atmelino/MPPT/README.md

# MPPT
Maximum Power Point Tracking Solar Powered Computer 

https://atmelino.github.io/MPPT/
