atmelino/MPPT/version4_0/README.md

# MPPT
Maximum Power Point Tracking Solar Powered Computer 

https://atmelino.github.io/MPPT/
