atmelino/MPPT/version1_0/README.md

# Arduino

Contents:

<h2>MPPT Arduino</h2>

Arduino code for Maximum Power Point Tracker project

<a href="https://hackaday.io/project/10671-arduino-mppt-solar-charge-controller">https://hackaday.io/project/10671-arduino-mppt-solar-charge-controller</a>
