atmelino/MPPT/version1_0/wiki_backup/images.md

images:

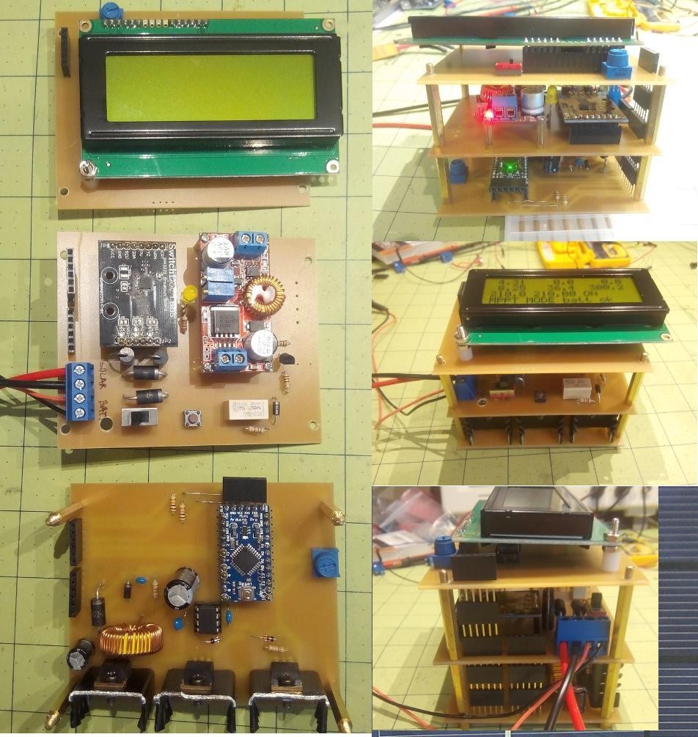
[picture p1: docs/wiki_backup/images/MPPT01.jpeg]
