atmelino/MPPT/docs/images/2oBEy.jpg

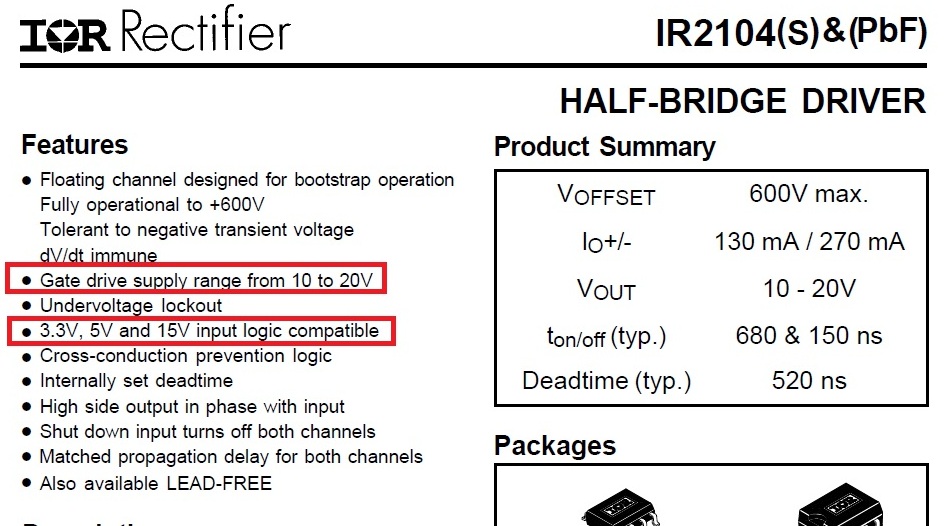
docs/images/2oBEy.jpg
