atmelino/MPPT/docs/images/currentlimit01.png

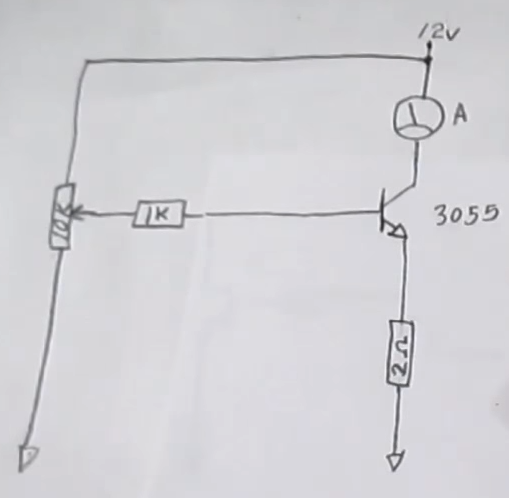
docs/images/currentlimit01.png
