atmelino/MPPT/docs/images/currentlimit02.png

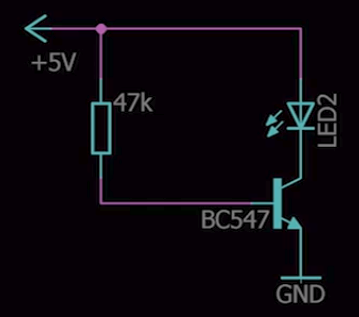
docs/images/currentlimit02.png
