atmelino/MPPT/docs/images/TykPZ.png

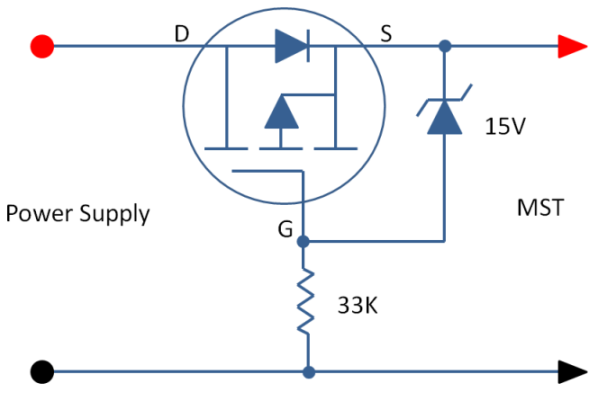
docs/images/TykPZ.png
