atmelino/MPPT/docs/images/version4_0/board.png

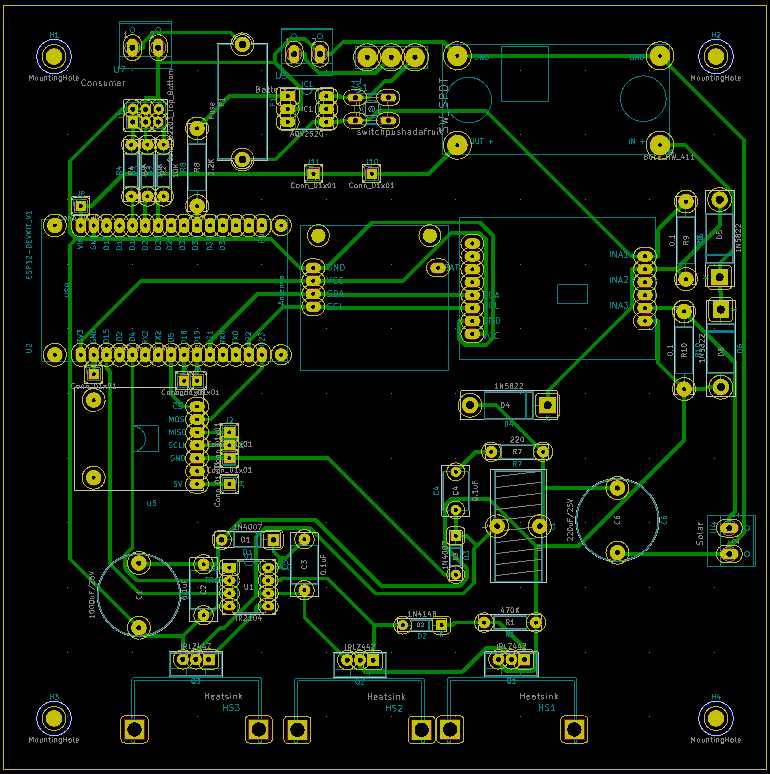
docs/images/version4_0/board.png
