atmelino/MPPT/docs/images/version4_0/schematic.png

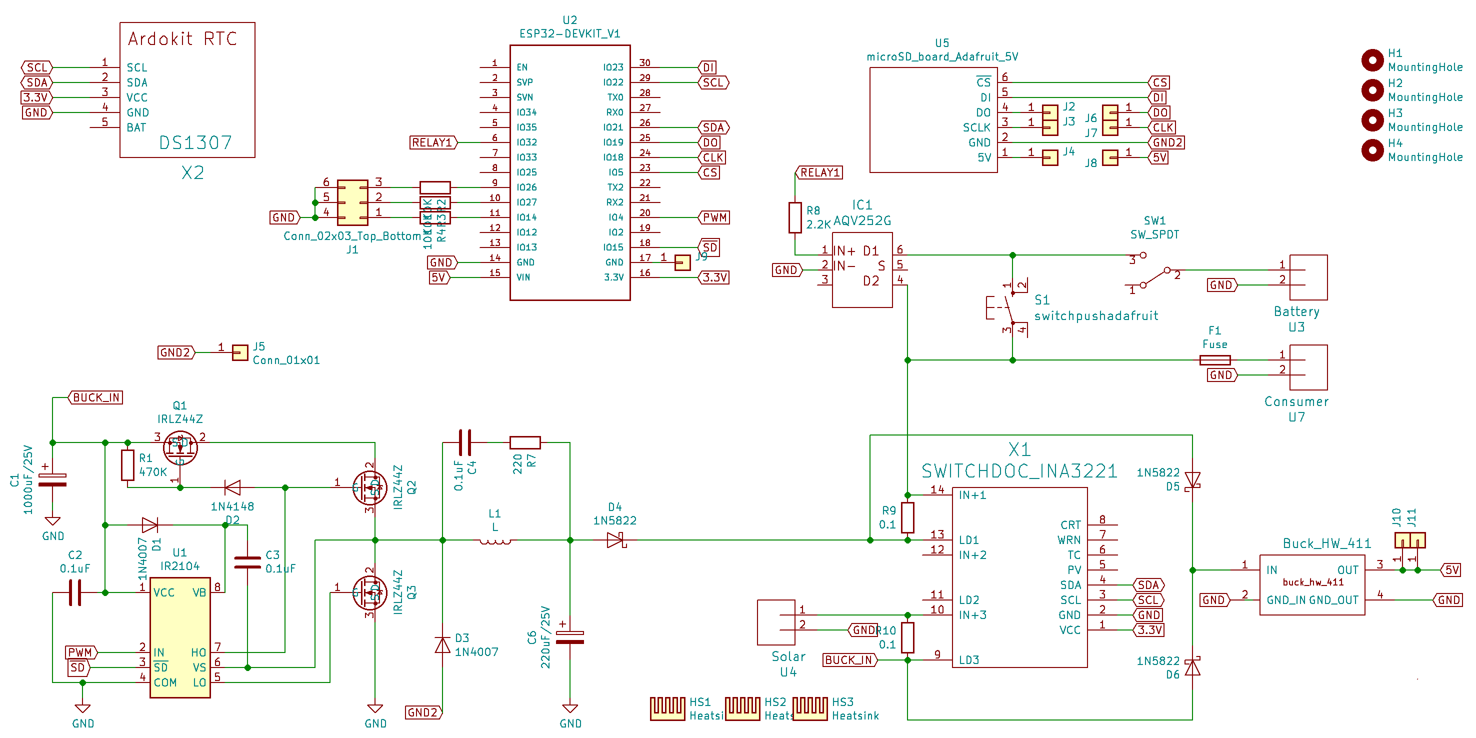
docs/images/version4_0/schematic.png
