atmelino/MPPT/version1_1/kicad/MPPT/MPPT_LCD_Pi/bak/2019_01_08_milled/MPPT_LCD_Pi-Top.pdf

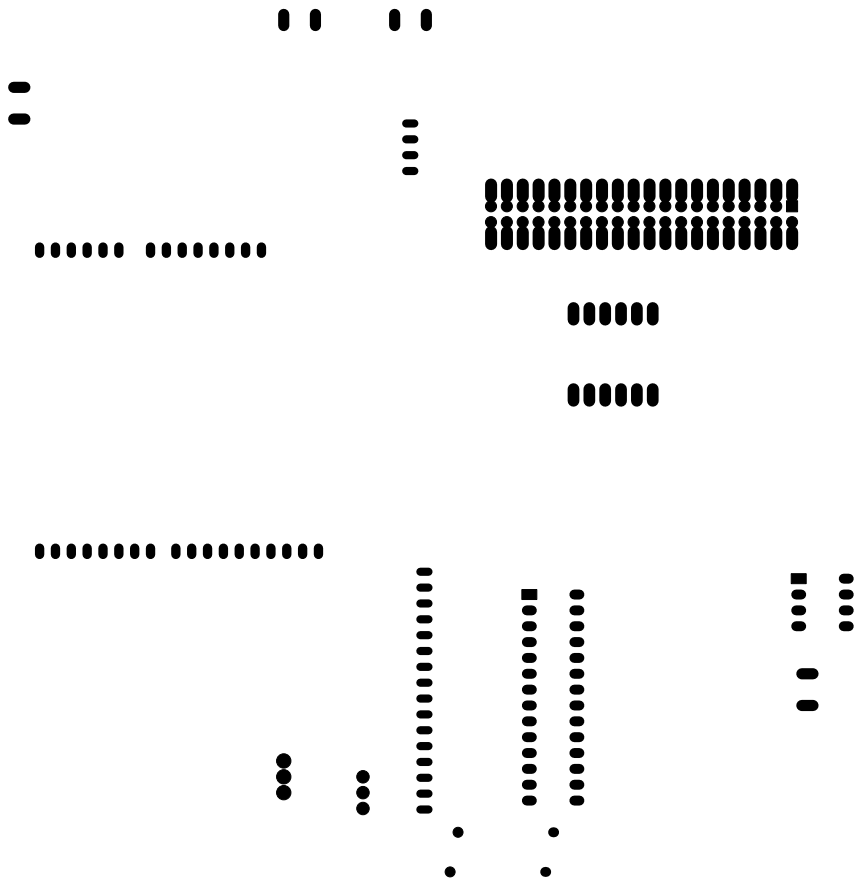
[picture p8: page 1]
