atmelino/MPPT/(list of files, drawings)

Other design files:
version1_1/kicad/MPPT/MPPT_LCD_Pi/bak/2019_01_08_milled/MPPT_LCD_Pi.dsn
version1_1/kicad/MPPT/MPPT_LCD_Pi/MPPT_LCD_Pi.dsn
version1_1/kicad/MPPT/MPPT_Solar/MPPT.dsn
