atmelino/MPPT/version1_1/kicad/MPPT/MPPT_LCD_Pi/bak/2019_01_08_milled/MPPT_LCD_Pi.kicad_pcb

## KiCad design version1_1/kicad/MPPT/MPPT_LCD_Pi/bak/2019_01_08_milled/MPPT_LCD_Pi.kicad_pcb (2019-01-29, an earlier design)

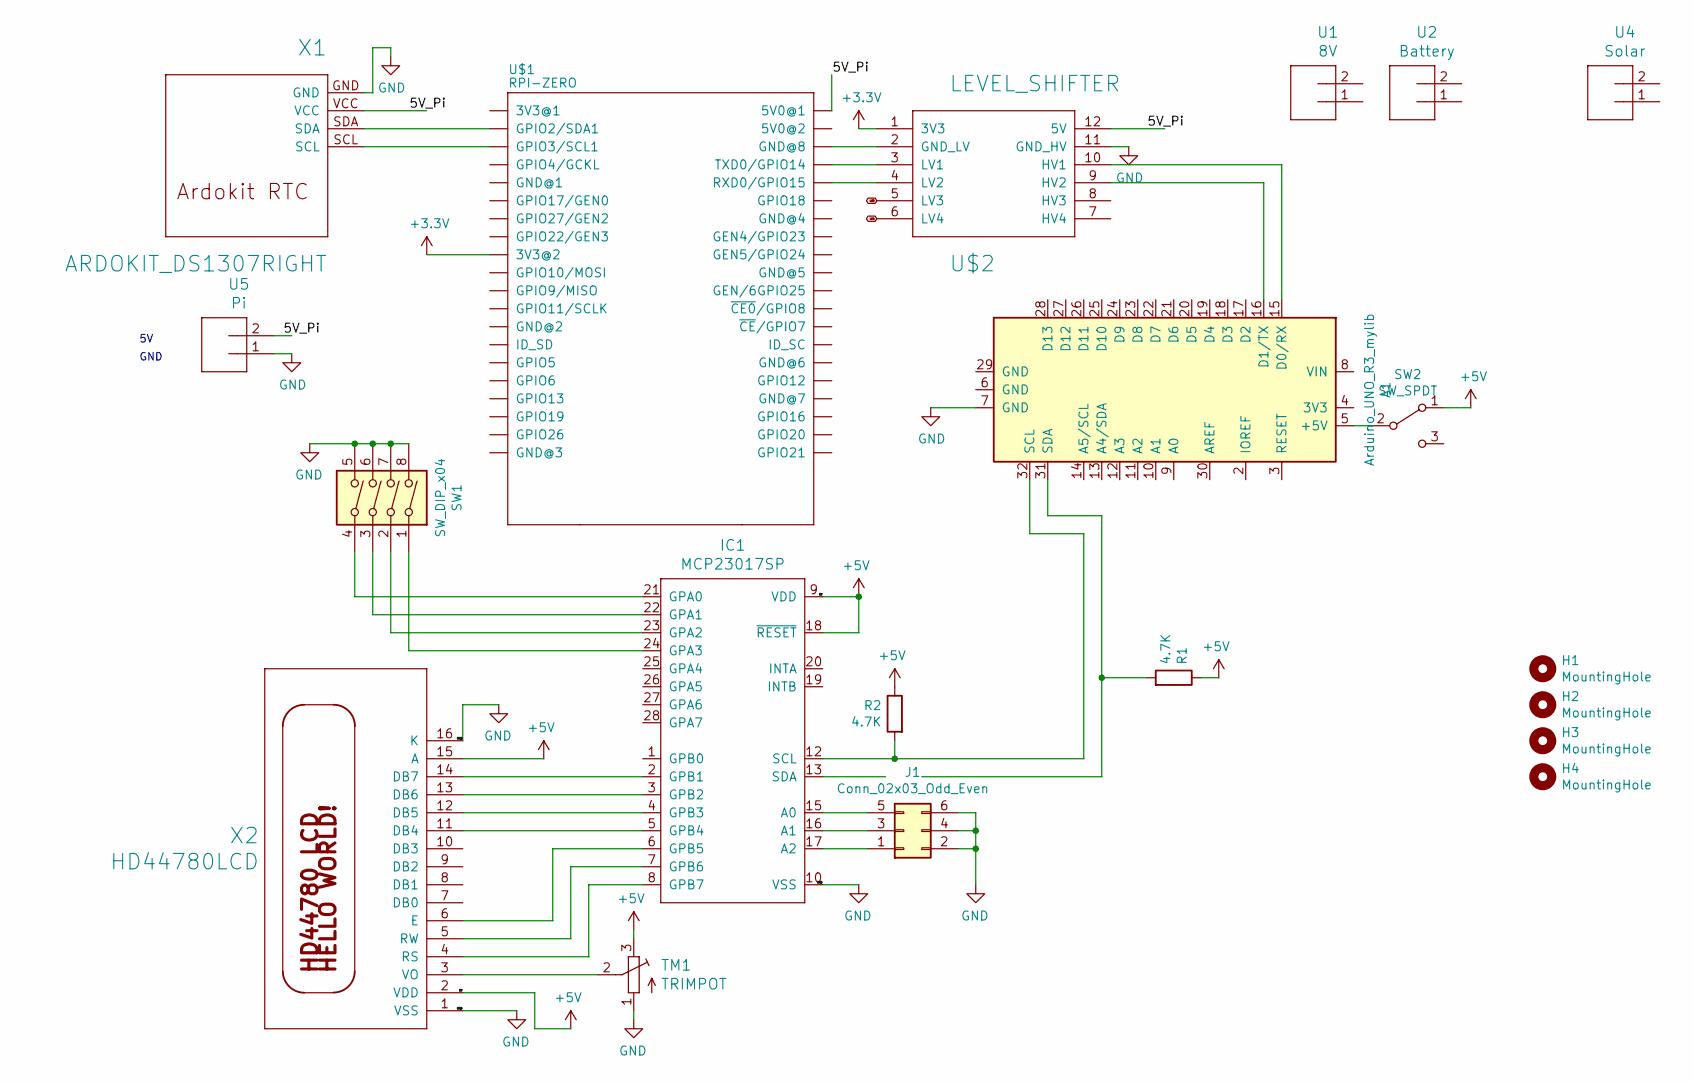
[picture p9: schematic MPPT_LCD_Pi.sch]

Parts:
A1: Arduino_UNO_R3_mylib; Arduino_UNO_R3_WithMountingHoles_mylib
H1, H2, H3, H4: MountingHole; MountingHole_3.2mm_M3
IC1: MCP23017SP; DIP-28_W7.62mm_Socket_LongPads
J1: Conn_02x03_Odd_Even; PinHeader_2x03_P2.54mm_Vertical
R1, R2: 4.7K; R_Axial_DIN0207_L6.3mm_D2.5mm_P10.16mm_Horizontal_fatpad
SW1: SW_DIP_x04; DIP-8_W7.62mm_Socket_LongPads
SW2: SW_SPDT; SWITCH-SPDT
TM1: TRIMPOT; blue_trimpot
U1: 8V; W237-132_screw_terminal
U2: Battery; W237-132_screw_terminal
U4: Solar; W237-132_screw_terminal
U5: Pi; W237-132_screw_terminal
U$1: RPI-ZERO; RASPBERRYPI_V13_EXTRAPADS
U$2: LEVEL_SHIFTER
X1: ARDOKIT_DS1307RIGHT; ARDOKIT_DS1307_RIGHT
X2: HD44780LCD; LCD_40_04

Connections:
+3V3: U$1.17 (3V3@2), U$1.17_LONG (3V3@2), U$2.1 (3V3)
+5V: IC1.9 (VDD), IC1.18 (~RESET), R1.1, R2.1, SW2.1 (A), TM1.3 (E), X2.2 (VDD), X2.15 (A)
/5V_Pi: U5.2, U$1.2 (5V0@1), U$1.2_LONG (5V0@1), U$2.12 (5V), X1.VCC
GND: A1.7 (GND), IC1.10 (VSS), J1.2, J1.4, J1.6, SW1.5, SW1.6, SW1.7, SW1.8, TM1.1 (A), U5.1, U$2.11 (GND_HV), X1.GND, X2.1 (VSS), X2.16 (K)
LV3: U$2.5 (LV3)
LV4: U$2.6 (LV4)
unnamed: A1.5 (+5V), SW2.2 (B)
unnamed: A1.15 (D0/RX), U$2.10 (HV1)
unnamed: A1.16 (D1/TX), U$2.9 (HV2)
unnamed: A1.31 (SDA), R1.2
unnamed: A1.32 (SCL), IC1.12 (SCL), R2.2
unnamed: IC1.2 (GPB1), X2.14 (DB7)
unnamed: IC1.3 (GPB2), X2.13 (DB6)
unnamed: IC1.4 (GPB3), X2.12 (DB5)
unnamed: IC1.5 (GPB4), X2.11 (DB4)
unnamed: IC1.6 (GPB5), X2.6 (E)
unnamed: IC1.7 (GPB6), X2.5 (RW)
unnamed: IC1.8 (GPB7), X2.4 (RS)
unnamed: IC1.15 (A0), J1.5
unnamed: IC1.16 (A1), J1.3
unnamed: IC1.17 (A2), J1.1
unnamed: IC1.21 (GPA0), SW1.4
unnamed: IC1.22 (GPA1), SW1.3
unnamed: IC1.23 (GPA2), SW1.2
unnamed: IC1.24 (GPA3), SW1.1
unnamed: TM1.2 (S), X2.3 (VO)
unnamed: U$1.1 (3V3@1), U$1.1_LONG (3V3@1)
unnamed: U$1.3 (GPIO2/SDA1), U$1.3_LONG (GPIO2/SDA1), X1.SDA
unnamed: U$1.4 (5V0@2), U$1.4_LONG (5V0@2)
unnamed: U$1.5 (GPIO3/SCL1), U$1.5_LONG (GPIO3/SCL1), X1.SCL
unnamed: U$1.6 (GND@8), U$1.6_LONG (GND@8), U$2.2 (GND_LV)
unnamed: U$1.7 (GPIO4/GCKL), U$1.7_LONG (GPIO4/GCKL)
unnamed: U$1.8 (TXD0/GPIO14), U$1.8_LONG (TXD0/GPIO14), U$2.3 (LV1)
unnamed: U$1.9 (GND@1), U$1.9_LONG (GND@1)
unnamed: U$1.10 (RXD0/GPIO15), U$1.10_LONG (RXD0/GPIO15), U$2.4 (LV2)
unnamed: U$1.11 (GPIO17/GEN0), U$1.11_LONG (GPIO17/GEN0)
unnamed: U$1.12 (GPIO18), U$1.12_LONG (GPIO18)
unnamed: U$1.13 (GPIO27/GEN2), U$1.13_LONG (GPIO27/GEN2)
unnamed: U$1.14 (GND@4), U$1.14_LONG (GND@4)
unnamed: U$1.15 (GPIO22/GEN3), U$1.15_LONG (GPIO22/GEN3)
unnamed: U$1.16 (GEN4/GPIO23), U$1.16_LONG (GEN4/GPIO23)
unnamed: U$1.18 (GEN5/GPIO24), U$1.18_LONG (GEN5/GPIO24)
unnamed: U$1.19 (GPIO10/MOSI), U$1.19_LONG (GPIO10/MOSI)
unnamed: U$1.20 (GND@5), U$1.20_LONG (GND@5)
unnamed: U$1.21 (GPIO9/MISO), U$1.21_LONG (GPIO9/MISO)
unnamed: U$1.22 (GEN/6GPIO25), U$1.22_LONG (GEN/6GPIO25)
unnamed: U$1.23 (GPIO11/SCLK), U$1.23_LONG (GPIO11/SCLK)
unnamed: U$1.24 (~CE0~/GPIO8), U$1.24_LONG (~CE0~/GPIO8)
unnamed: U$1.25 (GND@2), U$1.25_LONG (GND@2)
unnamed: U$1.26 (~CE~/GPIO7), U$1.26_LONG (~CE~/GPIO7)
unnamed: U$1.27 (ID_SD), U$1.27_LONG (ID_SD)
unnamed: U$1.28 (ID_SC), U$1.28_LONG (ID_SC)
unnamed: U$1.29 (GPIO5), U$1.29_LONG (GPIO5)
unnamed: U$1.30 (GND@6), U$1.30_LONG (GND@6)
unnamed: U$1.31 (GPIO6), U$1.31_LONG (GPIO6)
unnamed: U$1.32 (GPIO12), U$1.32_LONG (GPIO12)
unnamed: U$1.33 (GPIO13), U$1.33_LONG (GPIO13)
unnamed: U$1.34 (GND@7), U$1.34_LONG (GND@7)
unnamed: U$1.35 (GPIO19), U$1.35_LONG (GPIO19)
unnamed: U$1.36 (GPIO16), U$1.36_LONG (GPIO16)
unnamed: U$1.37 (GPIO26), U$1.37_LONG (GPIO26)
unnamed: U$1.38 (GPIO20), U$1.38_LONG (GPIO20)
unnamed: U$1.39 (GND@3), U$1.39_LONG (GND@3)
unnamed: U$1.40 (GPIO21), U$1.40_LONG (GPIO21)

Notes on the sheet:
GND

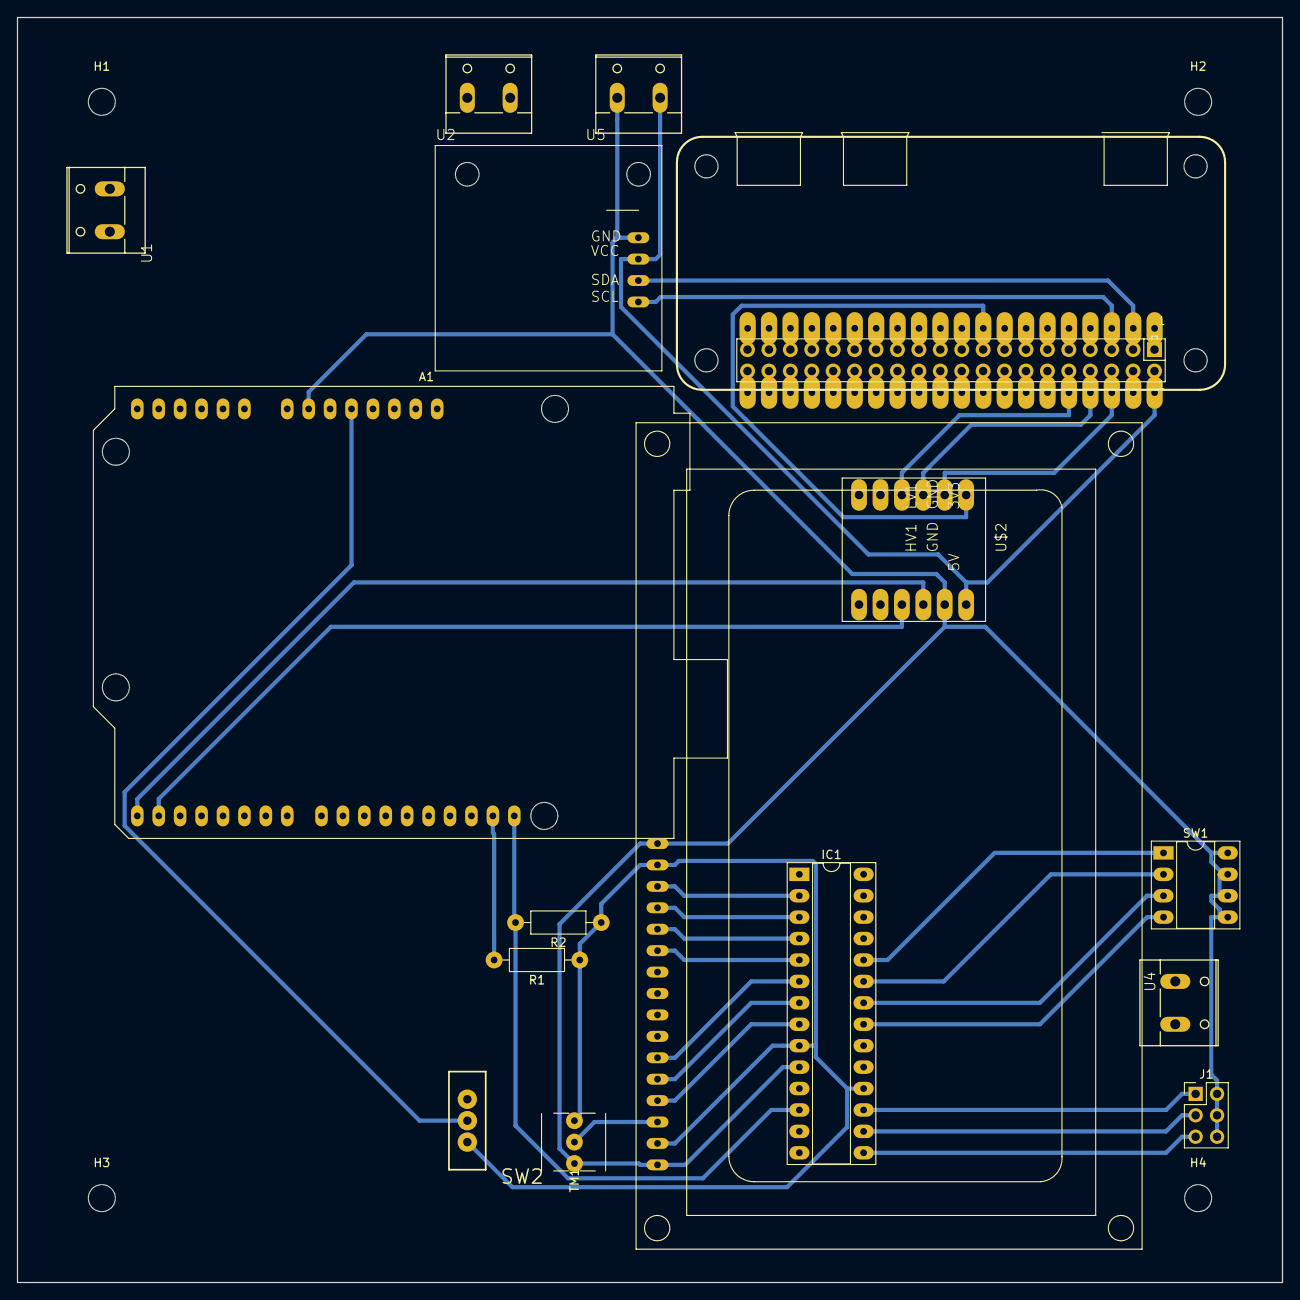
[picture p10: board MPPT_LCD_Pi.kicad_pcb from above]

Board: 2 copper layers, 150.0 x 150.0 mm, 20 parts (0 on the bottom side), 62 nets.
