atmelino/MPPT/version1_1/kicad/MPPT/MPPT_Solar/MPPT.kicad_pcb

## KiCad design version1_1/kicad/MPPT/MPPT_Solar/MPPT.kicad_pcb (2019-01-29, an earlier design)

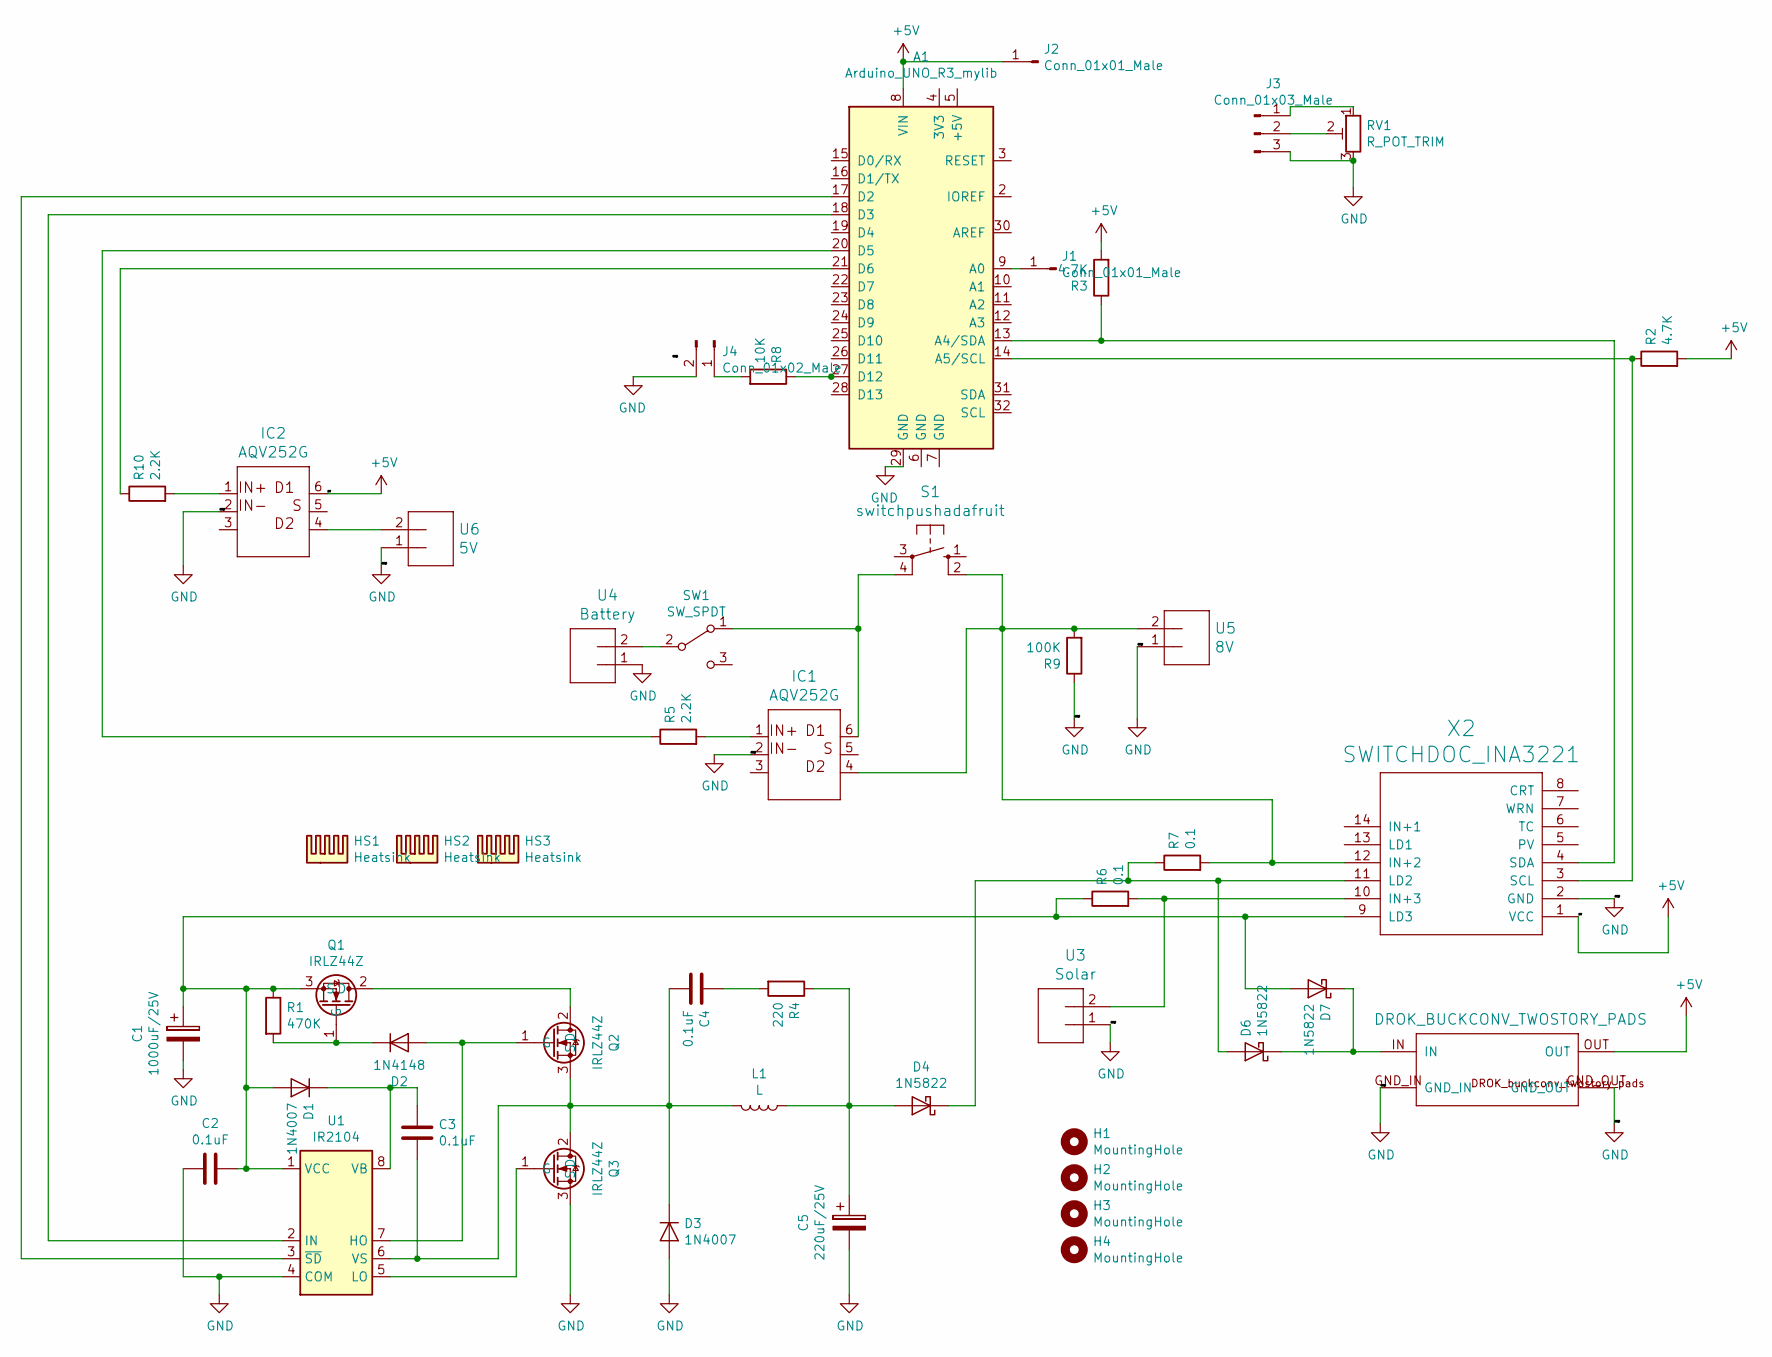
[picture p11: schematic MPPT.sch]

Parts:
A1: Arduino_UNO_R3_mylib; Arduino_UNO_R3
C1: 1000uF/25V; C_Radial_D16.0mm_H25.0mm_P7.50mm_mod
C2, C3: 0.1uF; C_Disc_D7.5mm_W5.0mm_P10.00mm
C4: 0.1uF; C_Disc_D7.5mm_W5.0mm_P7.50mm
C5: 220uF/25V; C_Radial_D18.0mm_H35.5mm_P7.50mm
D1, D3: 1N4007; D_DO-35_SOD27_P7.62mm_Horizontal_fatpad
D2: 1N4148; D_DO-35_SOD27_P7.62mm_Horizontal_fatpad
D4, D6, D7: 1N5822; D_DO-201AD_P15.24mm_Horizontal
H1, H2, H3, H4: MountingHole; MountingHole_3.2mm_M3
HS1, HS2, HS3: Heatsink; WAKEFIELD265
IC1, IC2: AQV252G; DIP-6_W7.62mm_Socket_LongPads
J1, J2: Conn_01x01_Male; PinHeader_1x01_P2.54mm_Vertical
J3: Conn_01x03_Male; PinHeader_1x03_P2.54mm_Vertical
J4: Conn_01x02_Male; PinHeader_1x02_P2.54mm_Vertical_fatpad
L1: L; L_Toroid_Vertical_L21.6mm_W9.1mm_P8.40mm_Bourns_5700_fatpad
Q1, Q2, Q3: IRLZ44Z; TO-220-3_Vertical
R1: 470K; R_Axial_DIN0207_L6.3mm_D2.5mm_P10.16mm_Horizontal_fatpad
R2, R3: 4.7K; R_Axial_DIN0207_L6.3mm_D2.5mm_P10.16mm_Horizontal_fatpad
R4: 220; R_Axial_DIN0207_L6.3mm_D2.5mm_P10.16mm_Horizontal_fatpad
R5, R10: 2.2K; R_Axial_DIN0207_L6.3mm_D2.5mm_P10.16mm_Horizontal_fatpad
R6, R7: 0.1; R_Axial_DIN0309_L9.0mm_D3.2mm_P15.24mm_Horizontal_pad3mm
R8: 10K; R_Axial_DIN0207_L6.3mm_D2.5mm_P10.16mm_Horizontal_fatpad
R9: 100K; R_Axial_DIN0207_L6.3mm_D2.5mm_P10.16mm_Horizontal_fatpad
RV1: R_POT_TRIM; blue_trimpot
S1: switchpushadafruit; B3F-10XX
SW1: SW_SPDT; SWITCH-SPDT_0.185_INCH
U1: IR2104; DIP-8_W7.62mm_LongPads
U2: DROK_BUCKCONV_TWOSTORY_PADS
U3: Solar; W237-132
U4: Battery; W237-132
U5: 8V; W237-132
U6: 5V; W237-132
X2: SWITCHDOC_INA3221; SWITCHDOC_INA3221_NODRILL

Connections:
+5V: A1.8 (VIN), IC2.6, J2.1, R2.2, R3.2, U2.OUT, X2.1 (VCC)
GND: A1.29 (GND), C1.2, C2.2, C5.2, D3.2 (A), IC1.2, IC2.2, J3.3, J4.2, Q3.3 (S), R9.1, RV1.3, U1.4 (COM), U2.GND_IN, U2.GND_OUT, U3.1, U4.1, U5.1, U6.1, X2.2 (GND)
unnamed: A1.9 (A0), J1.1
unnamed: A1.13 (A4/SDA), R3.1, X2.4 (SDA)
unnamed: A1.14 (A5/SCL), R2.1, X2.3 (SCL)
unnamed: A1.17 (D2), U1.3 (~SD)
unnamed: A1.18 (D3), U1.2 (IN)
unnamed: A1.20 (D5), R5.1
unnamed: A1.21 (D6), R10.1
unnamed: A1.27 (D12), R8.1
unnamed: C1.1, C2.1, D1.2 (A), D7.2 (A), Q1.3 (S), R1.1, R6.1, U1.1 (VCC), X2.9 (LD3)
unnamed: C3.1, C4.1, D3.1 (K), L1.2, Q2.3 (S), Q3.2 (D), U1.6 (VS)
unnamed: C3.2, D1.1 (K), U1.8 (VB)
unnamed: C4.2, R4.2
unnamed: C5.1, D4.2 (A), L1.1, R4.1
unnamed: D2.1 (K), Q1.1 (G), R1.2
unnamed: D2.2 (A), Q2.1 (G), U1.7 (HO)
unnamed: D4.1 (K), D6.2 (A), R7.1, X2.11 (LD2)
unnamed: D6.1 (K), D7.1 (K), U2.IN
unnamed: IC1.1, R5.2
unnamed: IC1.4, R7.2, R9.2, S1.2 (S1), U5.2, X2.12 (IN+2)
unnamed: IC1.6, S1.4 (P1), SW1.1 (A)
unnamed: IC2.1, R10.2
unnamed: IC2.4, U6.2
unnamed: J3.1, RV1.1
unnamed: J3.2, RV1.2
unnamed: J4.1, R8.2
unnamed: Q1.2 (D), Q2.2 (D)
unnamed: Q3.1 (G), U1.5 (LO)
unnamed: R6.2, U3.2, X2.10 (IN+3)
unnamed: SW1.2 (B), U4.2

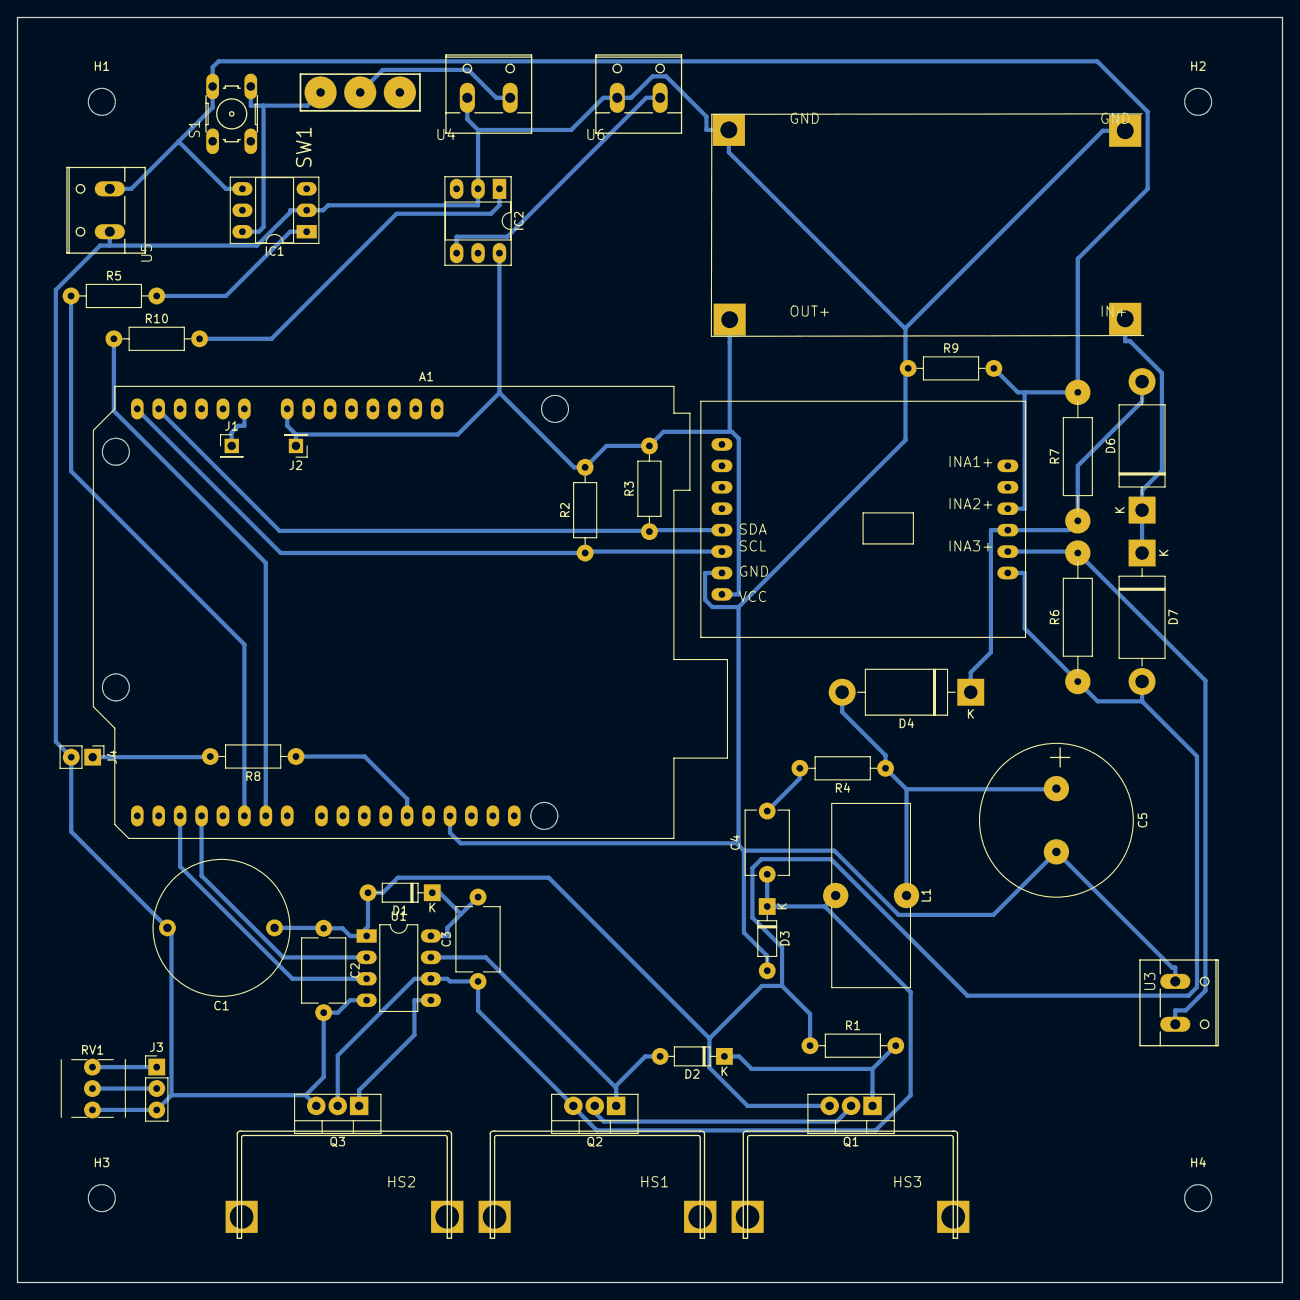
[picture p12: board MPPT.kicad_pcb from above]

Board: 2 copper layers, 150.0 x 150.0 mm, 49 parts (0 on the bottom side), 31 nets.
