atmelino/MPPT/version1_0/Eagle/MPPT_ArdProMini/MPPT_ArdProMini.brd

## EAGLE design version1_0/Eagle/MPPT_ArdProMini/MPPT_ArdProMini.brd (2019-01-30, an earlier design)

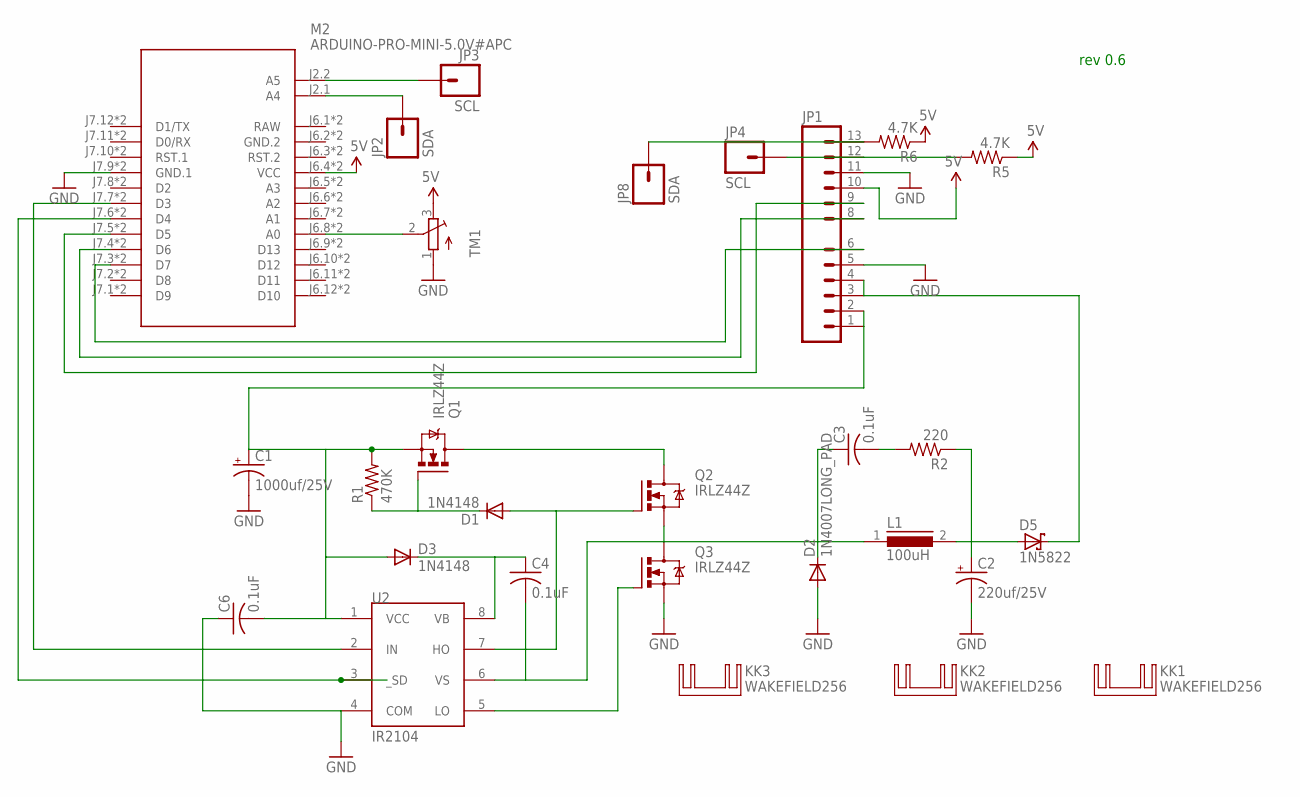
[picture p13: schematic MPPT_ArdProMini.sch]

Parts:
C1: 1000uf/25V; CPOL-RADIAL-1000UF-25V-KIT
C2: 220uf/25V; CPOL-RADIAL-1000UF-25V-KIT
C3: 0.1uF; C025-030X050
C4: 0.1uF; C050-030X075
C6: 0.1uF; C075-042X103
D1, D3: 1N4148; DO35-10
D2: 1N4007LONG_PAD; DO35-7
D5: 1N5822; DO201T15
JP1: M06_PLUS_06MPPT; M06_PLUS_06_MPPT
JP2, JP8: SDA; 1X01_OCT
JP3, JP4: SCL; 1X01_OCT
KK1, KK2, KK3: WAKEFIELD256; WAKEFIELD265
L1: 100uH; SFT830D
M2: ARDUINO-PRO-MINI-5.0V#APC; ARDUINO-PRO-MINI_EXTRAPADS
Q1, Q2, Q3: IRLZ44Z; TO220V
R1: 470K; 0204/7
R2: 220; 0204/7
R5, R6: 4.7K; 0204/7
TM1: TRIMPOT; TRIM-3386U
U2: IR2104; DIL08

Connections:
5V: JP1.10, M2.J6.4 (VCC), M2.J6.4_LONG (VCC), R5.1, R6.1, TM1.3 (E)
GND: C1.-, C2.-, C6.1, D2.A, JP1.5, JP1.11, M2.J7.9 (GND.1), M2.J7.9_LONG (GND.1), Q3.S, TM1.1 (A), U2.4 (COM)
GND.2: M2.J6.2 (GND.2), M2.J6.2_LONG (GND.2)
unnamed: M2.J6.8 (A0), M2.J6.8_LONG (A0), TM1.2 (S)
unnamed: JP1.12, JP4.1, R5.2
unnamed: Q3.G, U2.5 (LO)
unnamed: D1.C, Q1.G, R1.1
unnamed: JP1.9, M2.J7.5 (D5), M2.J7.5_LONG (D5)
unnamed: D5.C, JP1.3, JP1.4
unnamed: Q1.D, Q2.D
unnamed: JP1.8, M2.J7.4 (D6), M2.J7.4_LONG (D6)
unnamed: JP1.6, M2.J7.3 (D7), M2.J7.3_LONG (D7)
unnamed: C3.2, R2.2
unnamed: JP2.1, M2.J2.1 (A4)
unnamed: C3.1, C4.2, D2.C, L1.1, Q2.S, Q3.D, U2.6 (VS)
unnamed: C2.+, D5.A, L1.2, R2.1
unnamed: JP3.1, M2.J2.2 (A5)
unnamed: M2.J7.7 (D3), M2.J7.7_LONG (D3), U2.2 (IN)
unnamed: M2.J7.6 (D4), M2.J7.6_LONG (D4), U2.3 (_SD)
unnamed: D1.A, Q2.G, U2.7 (HO)
RAW: M2.J6.1 (RAW), M2.J6.1_LONG (RAW)
SDA: JP1.13, JP8.1, R6.2
VB: C4.1, D3.C, U2.8 (VB)
VCC: C1.+, C6.2, D3.A, JP1.1, JP1.2, Q1.S, R1.2, U2.1 (VCC)

Notes on the sheet:
rev 0.6

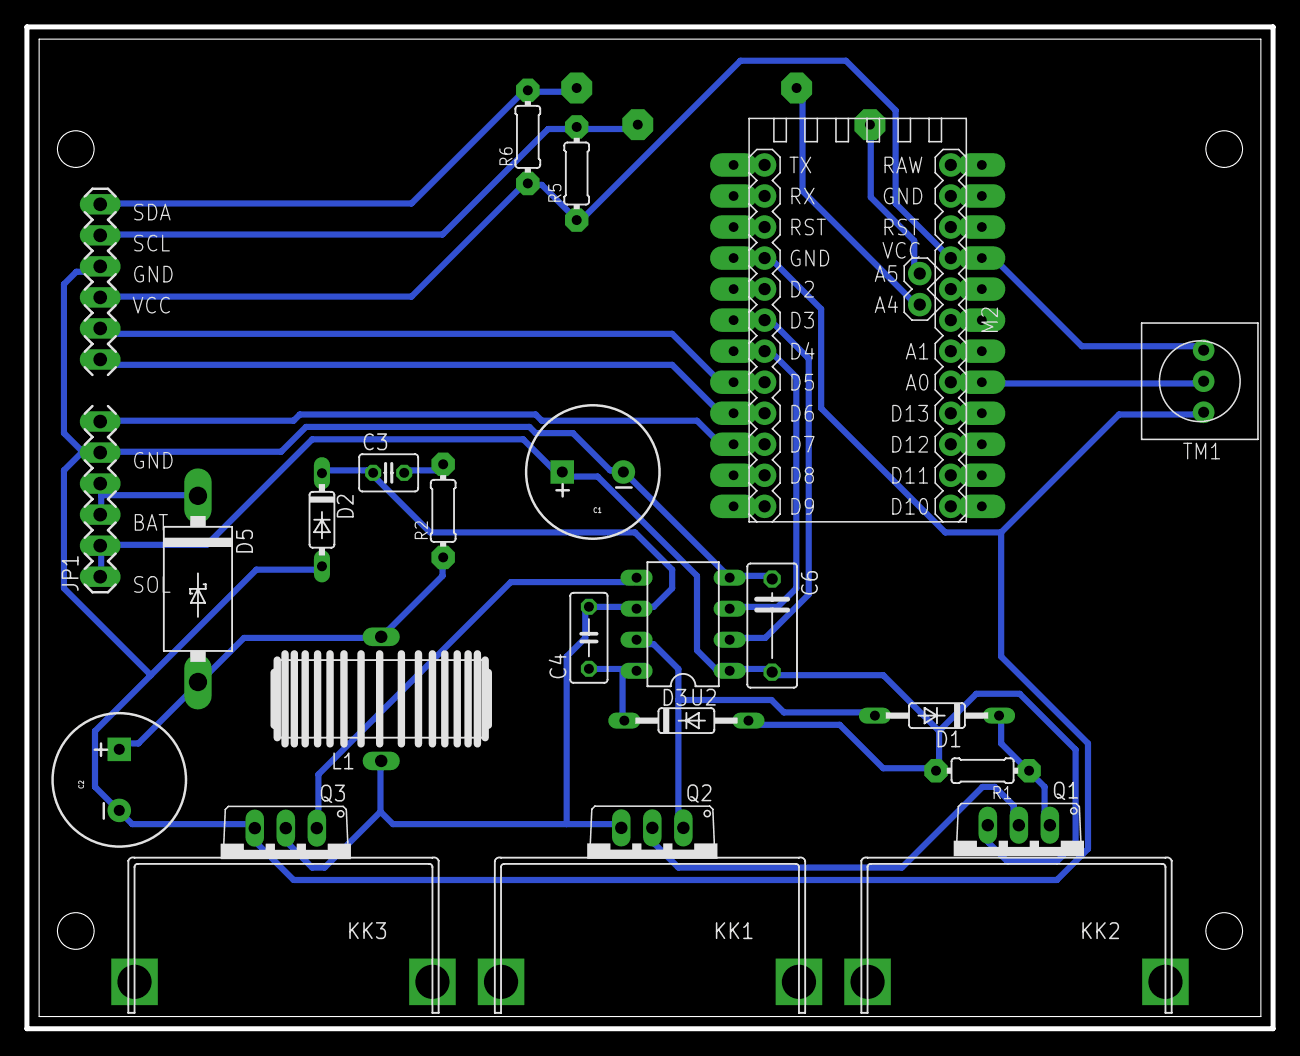
[picture p14: board MPPT_ArdProMini.brd from above]

Board: 2 copper layers, 102.0 x 82.0 mm, 28 parts (0 on the bottom side), 24 nets.
