atmelino/MPPT/version1_0/Eagle/MPPT_power/MPPT_power.brd

## EAGLE design version1_0/Eagle/MPPT_power/MPPT_power.brd (2019-01-30, an earlier design)

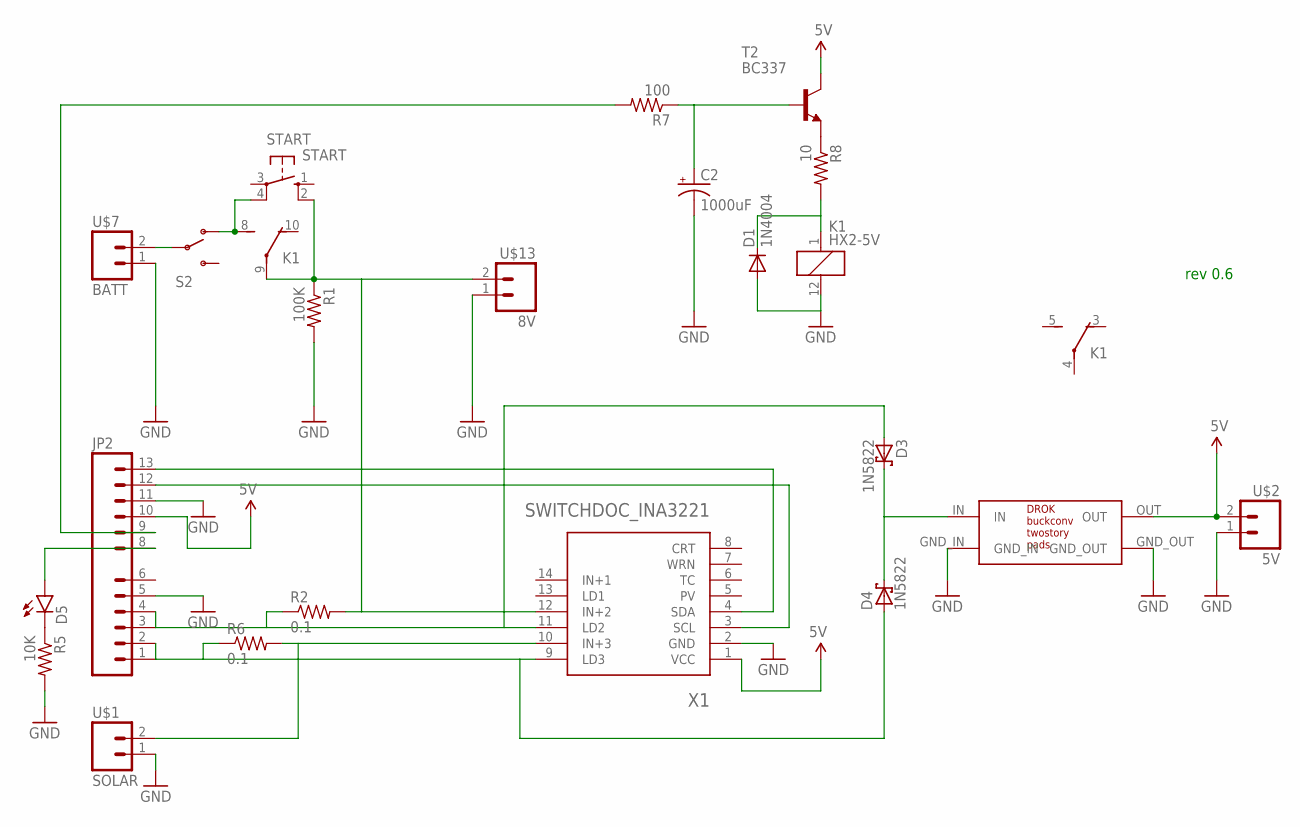
[picture p15: schematic MPPT_power.sch]

Parts:
C2: 1000uF; CPOL-RADIAL-1000UF-25V
D1: 1N4004; DO41-10
D3, D4: 1N5822; DO201T15
D5: LED5MM
JP2: M06_PLUS_06MPPT; M06_PLUS_06_MPPT
K1: HX2-5V; HX
R1: 100K; 0204/7
R2, R6: 0.1; 0204/7_PHAT_PAD
R5: 10K; 0204/7
R7: 100; 0204/7
R8: 10; 0204/7
S2: SWITCH-SPDT; SWITCH-SPDT_0.15_INCH
START: START; B3F-10XX
T2: BC337; TO92
U$1: SOLAR; W237-132
U$2: 5V; W237-132
U$3: DROK_BUCKCONV_TWOSTORY_PADS
U$7: BATT; W237-132
U$13: 8V; W237-132
X1: SWITCHDOC_INA3221; SWITCHDOC_INA3221_NODRILL

Connections:
5V: JP2.10, T2.3 (C), U$2.2, U$3.OUT, X1.1 (VCC)
GND: C2.-, D1.A, JP2.5, JP2.11, K1.12 (2), R1.2, R5.2, U$1.1, U$2.1, U$3.GND_IN, U$3.GND_OUT, U$7.1, U$13.1, X1.2 (GND)
unnamed: K1.9, R1.1, R2.2, START.2 (S1), U$13.2, X1.12 (IN+2)
unnamed: D3.C, D4.C, U$3.IN
unnamed: D5.K (C), R5.1
unnamed: D5.A, JP2.8
unnamed: S2.2, U$7.2
unnamed: R6.2, U$1.2, X1.10 (IN+3)
unnamed: R8.1, T2.1 (E)
unnamed: JP2.9, R7.2
unnamed: K1.8 (S), S2.1 (O), START.4 (P1)
unnamed: C2.+, R7.1, T2.2 (B)
unnamed: JP2.13, X1.4 (SDA)
unnamed: JP2.12, X1.3 (SCL)
unnamed: D1.C, K1.1, R8.2
unnamed: D3.A, JP2.3, JP2.4, R2.1, X1.11 (LD2)
unnamed: D4.A, JP2.1, JP2.2, R6.1, X1.9 (LD3)

Notes on the sheet:
rev 0.6

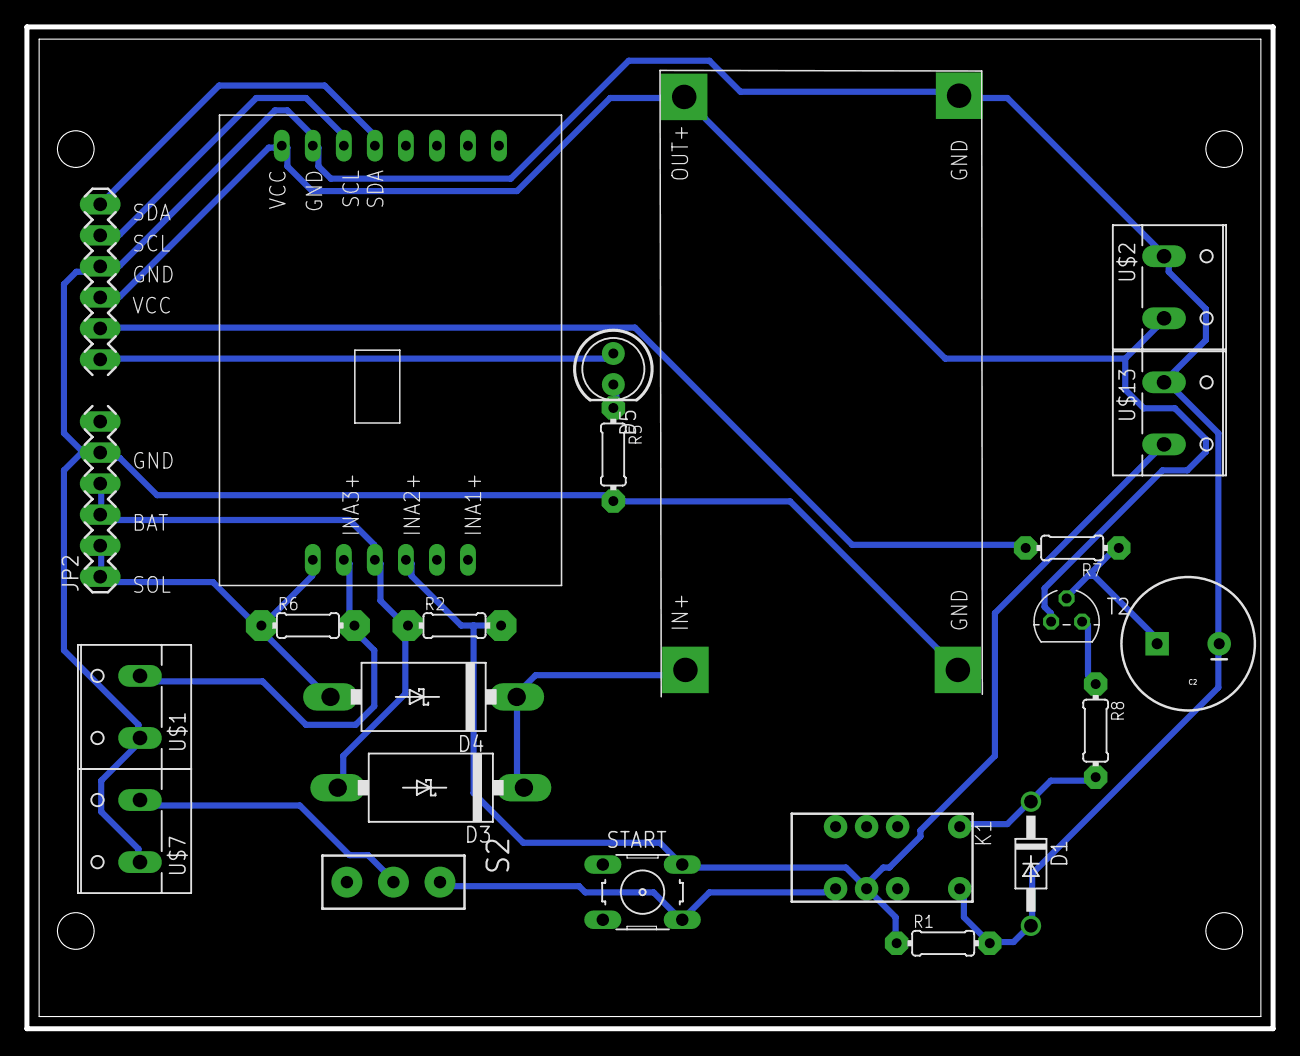
[picture p16: board MPPT_power.brd from above]

Board: 2 copper layers, 102.0 x 82.0 mm, 22 parts (0 on the bottom side), 17 nets.
