atmelino/MPPT/version1_0/Eagle/MPPT_LCD/MPPT_LCD.brd

## EAGLE design version1_0/Eagle/MPPT_LCD/MPPT_LCD.brd (2019-01-30, an earlier design)

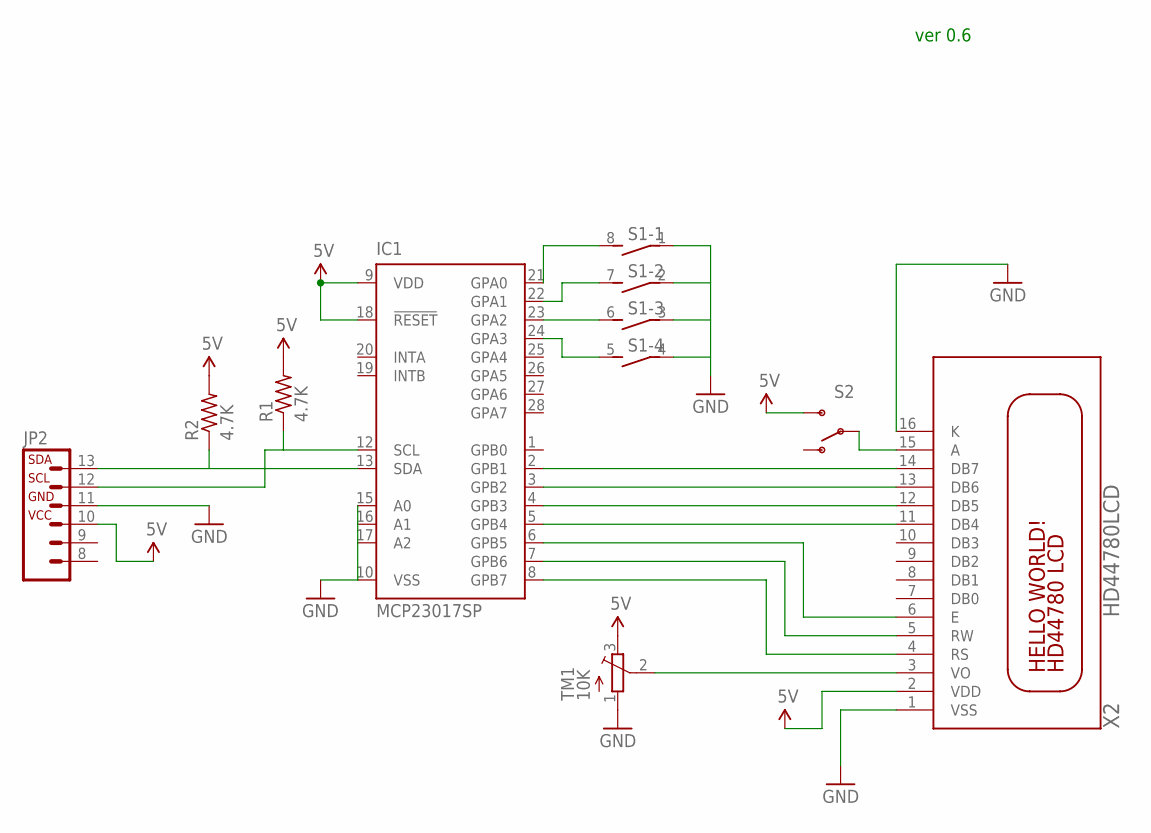
[picture p17: schematic MPPT_LCD.sch]

Parts:
IC1: MCP23017SP; DIL28-3
JP2: M06_MPPT_DATA
R1, R2: 4.7K; 0207/10
S1: DIP04S
S2: SWITCH-SPDTPTH; SWITCH-SPDT
TM1: 10K; TRIM-3386U
X2: HD44780LCD; LCD_40_04

Connections:
5V: IC1.9 (VDD), IC1.18 (!RESET), JP2.10, R1.2, R2.2, S2.3 (S), TM1.3 (E), X2.2 (VDD)
GND: IC1.10 (VSS), IC1.15 (A0), IC1.16 (A1), IC1.17 (A2), JP2.11, S1.1, S1.2 (1), S1.3 (1), S1.4 (1), TM1.1 (A), X2.1 (VSS), X2.16 (K)
unnamed: TM1.2 (S), X2.3 (VO)
unnamed: IC1.21 (GPA0), S1.8 (2)
unnamed: IC1.2 (GPB1), X2.14 (DB7)
unnamed: IC1.3 (GPB2), X2.13 (DB6)
unnamed: IC1.4 (GPB3), X2.12 (DB5)
unnamed: IC1.5 (GPB4), X2.11 (DB4)
unnamed: IC1.6 (GPB5), X2.6 (E)
unnamed: IC1.7 (GPB6), X2.5 (RW)
unnamed: IC1.8 (GPB7), X2.4 (RS)
unnamed: IC1.13 (SDA), JP2.13, R2.1
unnamed: IC1.12 (SCL), JP2.12, R1.1
unnamed: IC1.22 (GPA1), S1.7 (2)
unnamed: IC1.23 (GPA2), S1.6 (2)
unnamed: IC1.24 (GPA3), S1.5 (2)
unnamed: S2.2, X2.15 (A)

Notes on the sheet:
ver 0.6

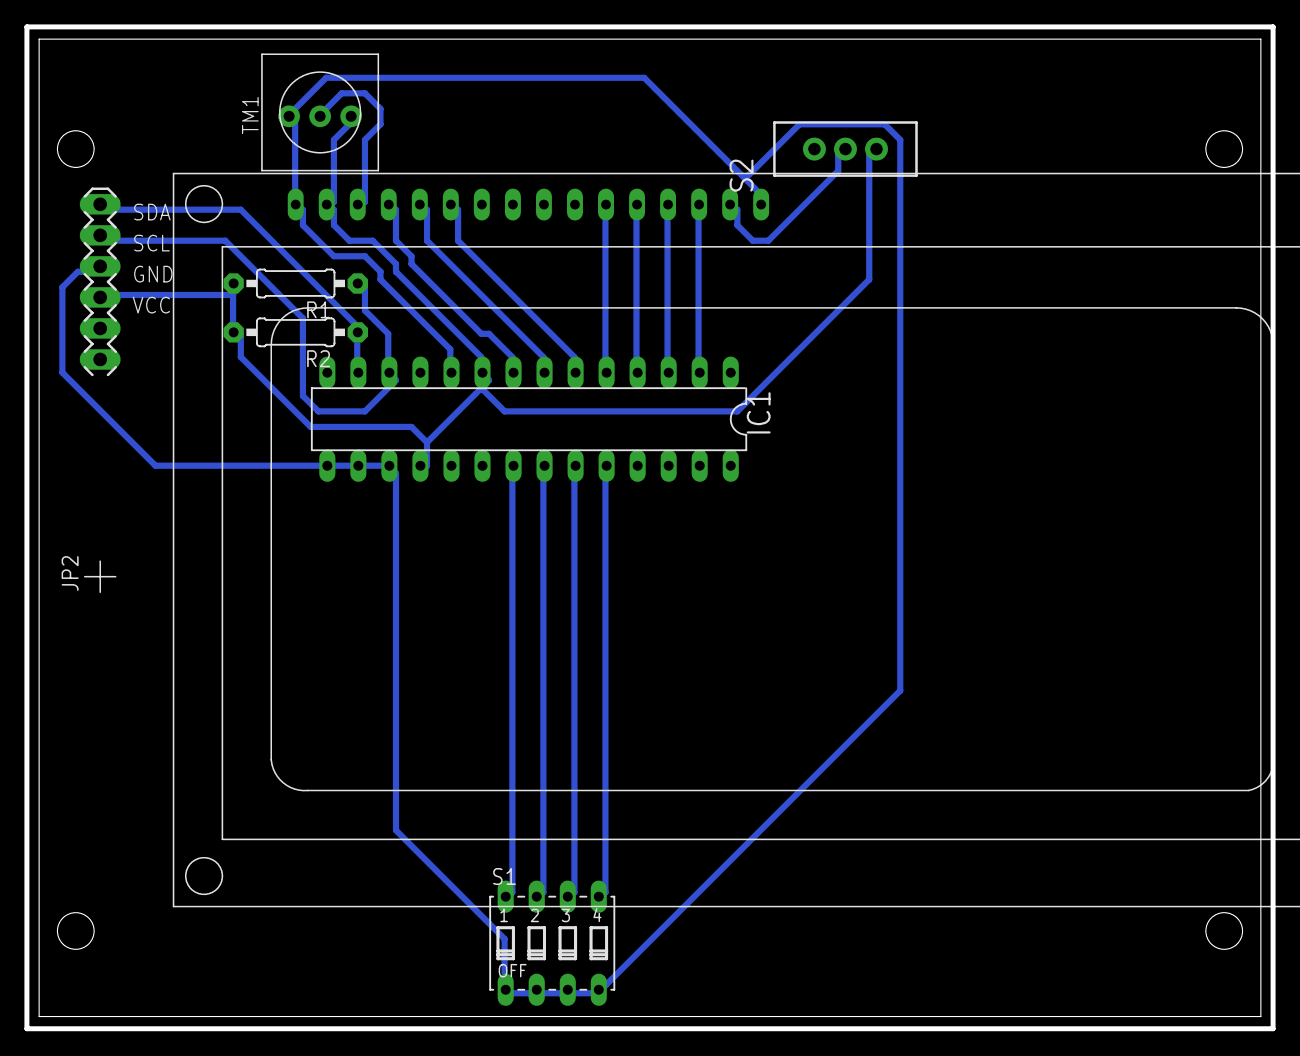
[picture p18: board MPPT_LCD.brd from above]

Board: 2 copper layers, 102.0 x 82.0 mm, 8 parts (0 on the bottom side), 17 nets.
