atmelino/MPPT/version4_0/ESP32/MPPT/MPPT.ino

// Import required libraries
#include "WiFi.h"
#include "ESPAsyncWebServer.h"
#include "SPIFFS.h"
#include <Wire.h>
#include <SDL_Arduino_INA3221.h>
#include <ArduinoJson.h>
#include "FS.h"
#include "SD.h"
#include "SPI.h"
#include "RTClib.h"

int debugLevel = 2; // 0=print nothing

// pin assignment
const int ledPin = 2; // on-board blue led (also internally pulled up)
const int green_LED = 14;
const int orange_LED = 27;
const int red_LED = 26;
const int PWM_OUT = 4;
const int PWM_ENABLE_PIN = 15;
const int RelayPin = 32;

// PWM
uint8_t PWM_actual = 100; // a value from 0 to 255
uint8_t PWM_requested = 130;
//boolean PWMModeMPPT = true;
boolean PWMModeMPPT = false;
//uint32_t freq = 82000;
uint32_t freq = 80000;
uint8_t resolution_bits = 8;
uint8_t channel = 1;

// Replace with your network credentials
const char* ssid = "NETGEAR53";
const char* password = "";
int count = 0;

RTC_DS1307 rtc;
char dateTime[20];
SDL_Arduino_INA3221 ina3221;
#define CHB 0 // Battery INA channel 1 but 0 for array
#define CHS 2// Solar INA channel 3 but 2 for array
float sv[3], bv[3], cmA[3], lv[3], pw[3];
char headerLine[80];
# define maxLines 240
char dataLines[maxLines][80];
int linePointer = 0;
boolean DataFilesYesNo = true;
int keepMeasurement = 1;
int DataFileLines = 10;

AsyncWebServer server(80);
AsyncWebSocket ws("/ws");

void setup(void)
{

  Serial.begin(115200);
  debugPrintln("MPPT ESP32", 1);

  if (! rtc.begin()) {
    Serial.println("Couldn't find RTC");
  }

  // Initialize SPIFFS
  if (!SPIFFS.begin(true)) {
    //Serial.println("An Error has occurred while mounting SPIFFS");
    return;
  }
  else {
    getSettings();

    //digitalWrite(ledPin, HIGH);
    //delay(300);
  }

  // Connect to Wi-Fi
  WiFi.begin(ssid, password);
  while (WiFi.status() != WL_CONNECTED) {
    digitalWrite(ledPin, LOW);
    delay(1000);
    digitalWrite(ledPin, HIGH);

    //Serial.println("Connecting to WiFi..");
  }

  // Print ESP32 Local IP Address
  Serial.println(WiFi.localIP());


  // Start server
  ws.onEvent(onWsEvent);
  server.addHandler(&ws);
  // Route for root / web pages and javascript
  server.on("/", HTTP_GET, [](AsyncWebServerRequest * request) {
    request->send(SPIFFS, "/index.html", "text/html");
  });
  server.on("/favicon.ico", HTTP_GET, [](AsyncWebServerRequest * request) {
    request->send(SPIFFS, "/favicon.png", "image/png");
  });
  server.on("/MPPT.css", HTTP_GET, [](AsyncWebServerRequest * request) {
    request->send(SPIFFS, "/MPPT.css", "text/css");
  });
  server.on("/MPPT.js", HTTP_GET, [](AsyncWebServerRequest * request) {
    request->send(SPIFFS, "/MPPT.js", "text/javascript");
  });
  server.begin();

  makeHeaderLine();
  Serial.println(headerLine);

  ina3221.begin();

  pinMode(ledPin, OUTPUT);
  digitalWrite(ledPin, LOW);// Turn off on-board blue led
  //digitalWrite(ledPin, HIGH);
  pinMode(green_LED, OUTPUT);
  pinMode(orange_LED, OUTPUT);
  pinMode(red_LED, OUTPUT);


  if (!SD.begin()) {
    Serial.println("Card Mount Failed");
    return;
  } else {
    Serial.println("Card Mount success");
    //createDirSD(SD, "/mydir");
    listDirSD(SD, "/", 2);
  }

  // PWM
  pinMode(PWM_ENABLE_PIN, OUTPUT); // GPIO as output
  digitalWrite(PWM_ENABLE_PIN, HIGH);
  ledcAttachPin(PWM_OUT, 1); // assign IR2104 PWM signal to channels
  // channels 0-15, resolution 1-16 bits, freq limits depend on resolution
  ledcSetup( channel,  freq, resolution_bits);
  PWM_actual = 190;
  ledcWrite(1, PWM_actual); //

  // Relay to battery
  pinMode(RelayPin, OUTPUT);
  digitalWrite(RelayPin, HIGH);

}

void loop(void)
{
  count++;

  // acquire voltages and currents
  for (int i = 0; i < 3; i++) {
    bv[i] = ina3221.getBusVoltage_V(i + 1);
    sv[i] = ina3221.getShuntVoltage_mV(i + 1);
    cmA[i] = ina3221.getCurrent_mA(i + 1);
    lv[i] = bv[i] + (sv[i] / 1000);
    pw[i] = bv[i] * cmA[i];
  }

  float batteryVoltage = bv[CHB];
  float solarVoltage = bv[CHS];
  float batteryCurrent = cmA[CHB];

  if (PWMModeMPPT) {
    if (batteryVoltage > 8.4) { // prevent battery overvoltage
      debugPrintln("battery over voltage, decrease PWM", 4);
      PWM_actual -= 5;
      setPWM();
    }
    if (abs(batteryCurrent) > 1050) {
      //Serial.println("battery over current");
      PWM_actual -= 5;
      setPWM();
    }
    if (solarVoltage > 10.0 && batteryVoltage >= 8.2) {
      debugPrintln("increase PWM slow", 4);
      PWM_actual += 1;
      setPWM();
    }
    if (solarVoltage > 10.0 && batteryVoltage < 8.2) {
      debugPrintln("increase PWM fast", 4);
      PWM_actual += 5;
      setPWM();
    }
    if (solarVoltage <= 10.0 && batteryVoltage >= 7.6) {
      debugPrintln("solar under voltage, stop PWM", 4);
      stopPWM();
    }
    if (solarVoltage <= 10.0 && batteryVoltage < 7.6) { // prevent battery over discharge
      //Serial.println("solar and battery under voltage");
      debugPrintln("solar and battery under voltage, low battery shutdown", 4);
      //logEntry("low battery shutdown");
      stopPWM();
      //DataFilesYesNo = false;
      //        if (true) {
      //          LEDblink();
      //          clearInterval(loopTimer);
      //          // give it a bit of time before turning off power
      //          setInterval(function () {
      //            rpio.write(relaypin, rpio.LOW);// disconnect battery
      //          }, 10000);
      //        }
    }

  } else {
    if (batteryVoltage > 8.4) // prevent battery overvoltage
    {
      Serial.println("battery over voltage");
      PWM_actual -= 5;
      PWM_requested = PWM_actual;
      setPWM();
    } else {
      //PWM_actual = PWM_requested;
      debugPrintln("manual mode set PWM", 4);
      setPWM();
    }
  }

  makeDataLine();
  debugPrint(dataLines[linePointer], 3);
  sendDataLine();

  linePointer++;
  if (linePointer >= maxLines  || linePointer >=  DataFileLines)
  {
    linePointer = 0;

    //    for (size_t i = 0; i < DataFileLines; i++) {
    //      debugPrint(dataLines[i], 4);
    //    }

    if (DataFilesYesNo) {
      writeDataFile(dateTime);
    }
  }

  //debugMsgln("Keep every " + keepMeasurement + " measurements", 0);
  //debugMsgln("count " + count + " remainder " + count % keepMeasurement, 0);
  //    if (count % keepMeasurement == 0) {
  //      bufferarray.push(line);
  //    }

  delay(1000);

}



void setPWM() {
  //if (PWM_actual > 254)    PWM_actual = 254;
  ledcWrite(1, PWM_actual); //
}

void startPWM() {
  PWM_actual = 100;
  digitalWrite(PWM_ENABLE_PIN, HIGH); // PWM on, enable IR2104
  ledcWrite(1, PWM_actual); //
}

void stopPWM() {
  PWM_actual = 0;
  digitalWrite(PWM_ENABLE_PIN, LOW); // PWM off, disable IR2104
}

void sendDataLine() {
  StaticJsonDocument<200> doc;
  char json_string[256];
  doc["type"] = "livedata";
  doc["data"] = dataLines[linePointer];
  serializeJson(doc, json_string);
  //Serial.println(json_string);
  ws.printfAll(json_string);
}

void makeDataLine() {
  makeDateTime();
  char* format = "%s %5d %.3f %.3f %.3f %.3f %.3f %.3f %4d\n";
  sprintf(dataLines[linePointer], format, dateTime, count, bv[CHS], cmA[CHS], pw[CHS], bv[CHB], cmA[CHB], pw[CHB], PWM_actual);
}

void makeHeaderLine() {
  char* format = "%19s %5s %6s %6s %6s %5s %5s %5s %3s";
  sprintf(headerLine, format, "Date", "no", "Volt", "mA", "mW", "Volt", "mA", "mW", "PWM");
}

void makeDateTime() {
  DateTime now = rtc.now();
  char* format = "%4d-%02d-%02d_%02d:%02d:%02d\0";
  sprintf(dateTime, format, now.year(), now.month(), now.day(), now.hour(), now.minute(), now.second());
}

void debugPrint(const char* message, int level) {
  //Serial.printf("level=%d debugLevel=%d\n", level, debugLevel);
  if (level <= debugLevel)
    Serial.print(message);
}

void debugPrintln(const char* message, int level) {
  if (level <= debugLevel)
    Serial.println(message);
}
