atmelino/MPPT/version4_0/ESP32/develop/SPIFFS_web_02/SPIFFS_web_02.ino

/*********
  Rui Santos
  Complete project details at https://randomnerdtutorials.com
*********/

// Import required libraries
#include "WiFi.h"
#include "ESPAsyncWebServer.h"
#include "SPIFFS.h"

// Replace with your network credentials
const char* ssid = "NETGEAR53";
const char* password = "";

// Set LED GPIO
const int ledPin = 2;
// Stores LED state
String ledState;

// Create AsyncWebServer object on port 80
AsyncWebServer server(80);

// Replaces placeholder with LED state value
String processor(const String& var) {
  Serial.println(var);
  if (var == "STATE") {
    if (digitalRead(ledPin)) {
      ledState = "ON";
    }
    else {
      ledState = "OFF";
    }
    //Serial.print(ledState);
    return ledState;
  }
  return String();
}

void setup() {
  // Serial port for debugging purposes
  //Serial.begin(115200);
  pinMode(ledPin, OUTPUT);

  // Initialize SPIFFS
  if (!SPIFFS.begin(true)) {
    //Serial.println("An Error has occurred while mounting SPIFFS");
    return;
  }
  else {
    digitalWrite(ledPin, HIGH);
    delay(300);
  }

  // Connect to Wi-Fi
  WiFi.begin(ssid, password);
  while (WiFi.status() != WL_CONNECTED) {
    digitalWrite(ledPin, LOW);
    delay(1000);
    digitalWrite(ledPin, HIGH);

    //Serial.println("Connecting to WiFi..");
  }

  // Print ESP32 Local IP Address
  //Serial.println(WiFi.localIP());

  // Route for root / web page
  server.on("/", HTTP_GET, [](AsyncWebServerRequest * request) {
    request->send(SPIFFS, "/index.html", String(), false, processor);
  });

  // Route to load style.css file
  server.on("/style.css", HTTP_GET, [](AsyncWebServerRequest * request) {
    request->send(SPIFFS, "/style.css", "text/css");
  });

  // Route to set GPIO to HIGH
  server.on("/on", HTTP_GET, [](AsyncWebServerRequest * request) {
    digitalWrite(ledPin, HIGH);
    request->send(SPIFFS, "/index.html", String(), false, processor);
  });

  // Route to set GPIO to LOW
  server.on("/off", HTTP_GET, [](AsyncWebServerRequest * request) {
    digitalWrite(ledPin, LOW);
    request->send(SPIFFS, "/index.html", String(), false, processor);
  });

  // Start server
  server.begin();
}

void loop() {

}
