atmelino/MPPT/version4_0/ESP32/develop/Blink_test01/Blink_test01.ino

const int green_LED = 14;


// the setup function runs once when you press reset or power the board
void setup() {
  // initialize digital pin LED_BUILTIN as an output.
  pinMode(green_LED, OUTPUT);
}

// the loop function runs over and over again forever
void loop() {
  digitalWrite(green_LED, HIGH);   // turn the LED on (HIGH is the voltage level)
  delay(1000);                       // wait for a second
  digitalWrite(green_LED, LOW);    // turn the LED off by making the voltage LOW
  delay(1000);                       // wait for a second
}
