atmelino/MPPT/version4_0/ESP32/develop/ds1307_test02/ds1307_test02.ino

// Date and time functions using a DS1307 RTC connected via I2C and Wire lib
#include "RTClib.h"

RTC_DS1307 rtc;
char dateTime[20];

char daysOfTheWeek[7][12] = {"Sunday", "Monday", "Tuesday", "Wednesday", "Thursday", "Friday", "Saturday"};

void setup () {
  while (!Serial); // for Leonardo/Micro/Zero

  Serial.begin(115200);
  if (! rtc.begin()) {
    Serial.println("Couldn't find RTC");
    while (1);
  }

  if (! rtc.isrunning()) {
    Serial.println("RTC is NOT running!");
    // following line sets the RTC to the date & time this sketch was compiled
    // rtc.adjust(DateTime(F(__DATE__), F(__TIME__)));
    // This line sets the RTC with an explicit date & time, for example to set
    // January 21, 2014 at 3am you would call:
    // rtc.adjust(DateTime(2014, 1, 21, 3, 0, 0));
  }

  //  rtc.adjust(DateTime(2014, 1, 21, 3, 0, 0));
  rtc.adjust(DateTime(F(__DATE__), F(__TIME__)));

}

void loop () {
  DateTime now = rtc.now();

  sprintf(dateTime, "%4d-%02d-%02d_%02d:%02d:%02d\0", now.year(), now.month(),now.day(),now.hour(),now.minute(),now.second());

  Serial.println(dateTime);
  delay(3000);
}
