atmelino/MPPT/(commit log)

2019-01-29 kicad files
    [MPPT.dsn, MPPT.kicad_pcb, MPPT.sch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]
2019-01-30 import Arduino
    [MPPT_ArdProMini.brd, MPPT_ArdProMini.sch, MPPT_LCD.brd, MPPT_LCD.sch, MPPT_power.brd, MPPT_power.sch]
2019-01-30 import raspberry pi
2019-02-10 display actual PWM
2019-02-15 3.3 Volt
2019-02-25 I2C and INA3221
2019-02-26 INA3221 and STM32
    [UARTprint Debug.cfg]
2019-02-27 print INA3221 values as hex
2019-03-08 reorganize by versions, docs
    [MPPT.dsn, MPPT.kicad_pcb, MPPT.sch, MPPT_ArdProMini.brd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]
2019-03-11 charge LED
2019-03-17 buck circuit
2019-03-19 console.log stalls program
2019-04-02 PWM off when no solar
2019-04-03 pwm and frequency when solar off
2019-04-04 battery protection
2019-04-11 battery connect
2019-04-15 SD card Arduino
2019-04-24 web socket closes
2019-05-01 multiple I2C devices
2019-05-01 relay pin
2019-05-01 LED pins
2019-05-02 LED battery level indicators
2019-05-02 LED indicators
2019-05-03 battery PWM conditions
2019-05-07 low battery shutdown
2019-08-28 ESP32 initial
2019-09-02 wifi connected LED
2019-09-05 PWM and INA3221
2019-09-05 PWM enable pin, web wifi
2019-09-16 websocket PWM
2019-09-17 web PWM set
2019-09-18 PWM control
2019-10-09 new PCB
2019-10-13 power indicator LEDs
2019-10-14 battery relay
2019-10-14 PWM half bridge driver on off
